straguz/hybrid-tube-amp/docs/bom+calcs.xlsx

Sheet: Calculations
Transistor V_BE: | 0.65 | small signal, nominal |  | Load resistance | 4 | Ohm |  | Transistor V_BE,min: | 0.2 V | For output devices at max temp
Supply voltage: | 32 | + and - |  | Worst case signal amplitude | 20.384 | V |  | Transitor V_BE, max | 1V | For output devices at min temp, worst tolerances
Input stage params: |  |  |  | VAS params |  |  |  | Output stage params
Standing Current | 0.01 | A |  | Standing current: | 0.01 | A |  | Pre-driver current: | 0.01 | A
Triode gates | 0 | V |  | R221: | 20 | Ohm |  | Driver current: | 0.015 | A
Triode cathodes | 0.7 | V | Vgk, from datasheet curves | R218: | 1000 | Ohm |  | Rballast | 0.1 | Ohm
R203, R206 | 50 | Ohm |  | R219: | 130 | Ohm |  | Vballast | 0.026 | V
R211 | 33000 | Ohm |  | RV201 | 1000 | Ohm |  | h_FE, output devices | 50
R212 | 133000 | Ohm |  | R222 | 18 | Ohm |  | h_FE, driver devices | 100
R208,209 | 10000 | Ohm |  | R216 | 10000 | Ohm |  | n output pairs | 2 | number of npn and pnp output device pairs
 |  |  |  | Q211,vce_cutoff: | 0.5 | V |  | reactive load derating: | 2 | effective current increase from reactive loads
 |  |  |  | Q213,vce_cutoff: | 0.5 | V
Input stage calcs: |  |  |  | VAS calcs: |  |  |  | Output calcs:
R211,R212 current: | 0.0001885542169 | A |  | R221 Vdrop | 0.2 | V |  | Quiescent current, output: | 0.26 | A
R211,R212 voltage divider: | 25.77771084 | V |  | Current limit | 0.0325 | A |  | Quiescent base current, output (per-device): | 0.0052 | A
C202,min: | 1.196653707 | uF | 1 Hz cutoff | R223: | 65 | Ohm |  | Output stage bias voltage: | 1.352 | V
Triode anodes: | 25.12771084 | V |  | Q210,Vc: | -30.7 | V |  | R229: | 90.13333333 | Ohm
Triode V_ak: | 24.42771084 | V | Design target 25V | Q210,Ic: | 0.00307 | A |  | Driver stage bias voltage: | 2.652 | V
R203,R206 Vdrop: | 0.25 | V |  | I,vbe_bias,min_bias: | 0.0005752212389 | A |  | R226: | 265.2 | Ohm
Q205 Vec: | 0.65 | V |  | I,vbe_bias,max_bias: | 0.005 | A |  | Bias generator voltage: | 3.952 | V
Q205 Vc (abs): | 31.1 | V |  | R222 Vdrop,min_bias | 0.1696460177 | V
Q201, Vc (abs): | 30.5 | V |  | R222 Vdrop,max_bias | 0.09 | V |  | Iout,peak: | 16 | A | Assumes rail to rail, and with 2x reactive load, so worst case
Q201, Vec: | 1.25 | V |  | Vbe_min_bias: | 1.055575221 | V | pot at max | Iout,rms,per device: | 4 | A | Divides evenly into all output pairs, and each conducts half the time
Q202,Vce: | 5.372289157 | V |  | Vbe_max_bias: | 5.56 | V | pot at 0 | Ib,rms,per device | 0.16 | A | Supplied by driver stage
Q206,Vce: | 5.972289157 | V |  | Q212,Ve: | -1.976 | V |  | Ib,driver,rms: | 0.0016 | A | Supplied by pre-drivers
R204: | 65 | Ohm |  | Q212,Vc: | 1.976 | V |  | Ib,pre-driver,rms: | 1.6e-05 | A | Supplied by VAS. negligible level for VAS calculations
Q207,Vc: | -30.7 | V |  | Q211,Vc,nom: | 2.105823009 | V | Rough mid-level R222 drop
Q207,Ic: | 0.001535 | A |  | Pos swing: | 29.19417699 | V |  | Pq,output,per | 8.32 | W
Q203,Vg: | -15.35 | V |  | Neg swing: | -28.874 | V |  | Pq,rballast,per | 0.00676 | W
Q204,Vc: | -16 | V |  | max rms: | 20.4170012 | V | before clipping | Q216,217 Pq: | 0.46986 | W
C201: | 31.83098862 | uF | minimum value for 1Hz cutoff | max load power: | 104.2134845 | W | At clipping | R229 Pq: | 0.02028 | W
 |  |  |  |  |  |  |  | Q214,215 Pq: | 0.0030674 | W
Input stage device power: | assumes all current in that device's branch |  |  | VAS device power: |  |  |  | R226 Pq: | 0.02652 | W
R203,R206: | 0.005 | W |  |  | 0.002 | W |  | Pq,total: | 34.2996948 | W | Total output stage power consumption, quiescent
Q201: | 0.0125 | W |  | Q211,quiescent | 0.2972453097 | W
Q205: | 0.0065 | W |  | R222 | 0.001598876185 | W |  | Poutput,signal,worst | 51.938432 | W | Assuming 40% load power
Q202: | 0.05372289157 | W |  | R218 | 0.025 | W |  | Poutput,per,worst | 34.289216 | W | Quiescent+signal power times reactivity factor
Q206: | 0.05972289157 | W |  | R219 | 0.00325 | W |  | Prballast,per,worst | 1.6 | W | Happens at full load power
Triodes: | 0.2442771084 | W |  | Q213,quiescent | 0.29374 | W |  | Poutput,total,worst: | 137.156864 | W | Signal output plus quiescent at worst-case load power
Q203: | 0.167 | W |  | R223 | 0.0065 | W |  | Pdriver,per,worst | 0.98924432 | W | Signal delivery requirements (output bases) plus quiescent at worst-case load
Q204: | 0.1535 | W |  | R216 | 0.094249 | W |  | Ppre-driver,per,worst | 0.0392712672 | W | Signal delivery requirements (driver bases) plus quiescent at worst-case load
R204: | 0.0065 | W |  | Q210 | 0.003991 | W
R208,209: | 0.02356225 | W |  |  |  |  |  | Poutput,total,worst-case | 139.8321796 | W | Not including power delivered to speakers
Q207: | 0.0019955 | W |  |  |  |  |  | Poutput,total,worst-case | 191.7706116 | W | Including power delivered to speakers
R211: | 0.001173238859 | W
R212 | 0.004728508129 | W
 |  |  |  | Total | 0.73824 | W | Ic*2x supplies, plus current mirror bias
Total: | 0.68912 | W | Ic*2x supplies, plus current mirror bias

Sheet: Other calculations
Gain:
R235 | 22000 | Ohm |  | max signal output,rms | 20.4170012
R234 | 1200 | Ohm
C205 | 1000 | uF
cutoff | 0.1326291192 | Hz
gain (V/V) | 19.33333333
gain (dB) | 25.72613478
sensitivity | 1.056051786 | V | max input voltage before clipping
