straguz/hybrid-tube-amp/hybrid-tube-amp.pdf

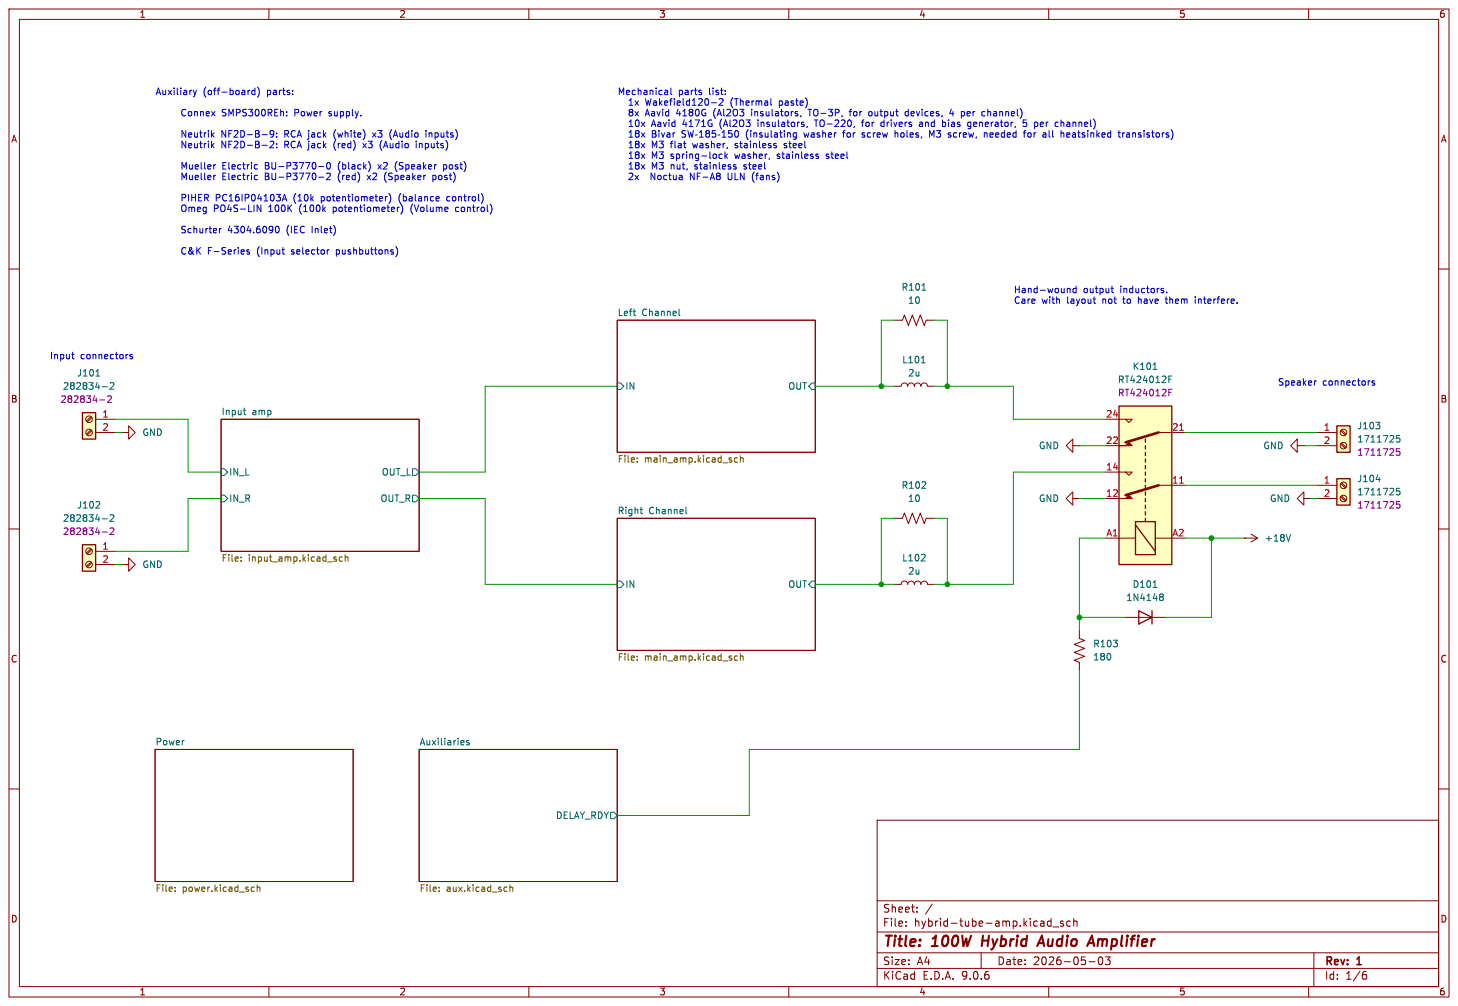
[picture p1: page 1]

Id: 1/6 Title: 100W Hybrid Audio Amplifier File: hybrid-tube-amp.kicad_sch Sheet: /

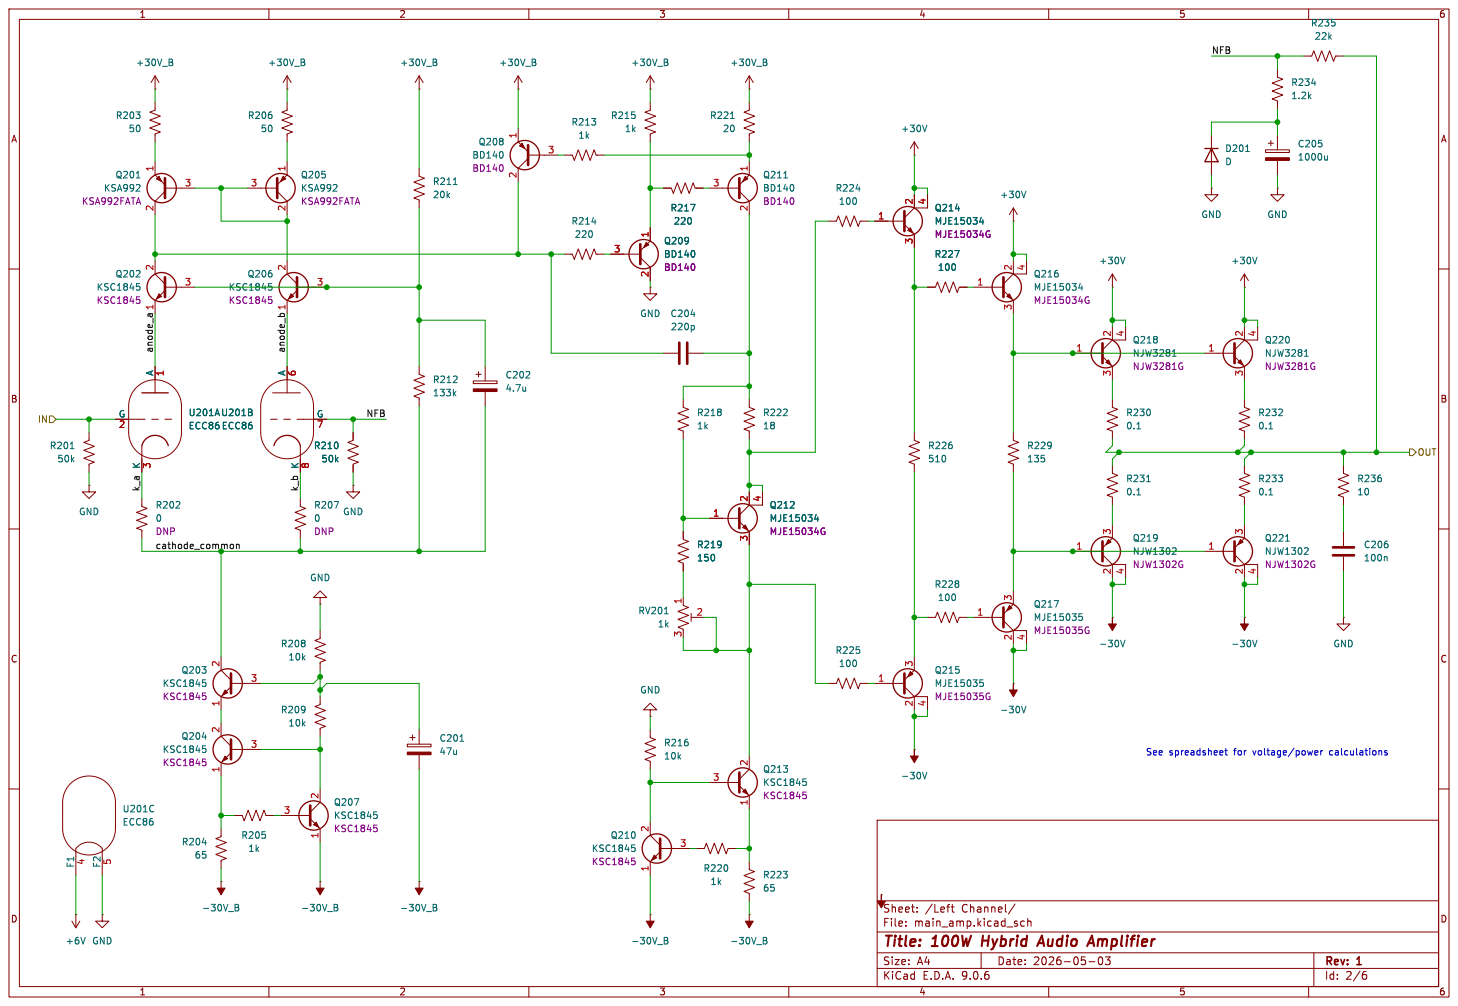
[picture p2: page 2]

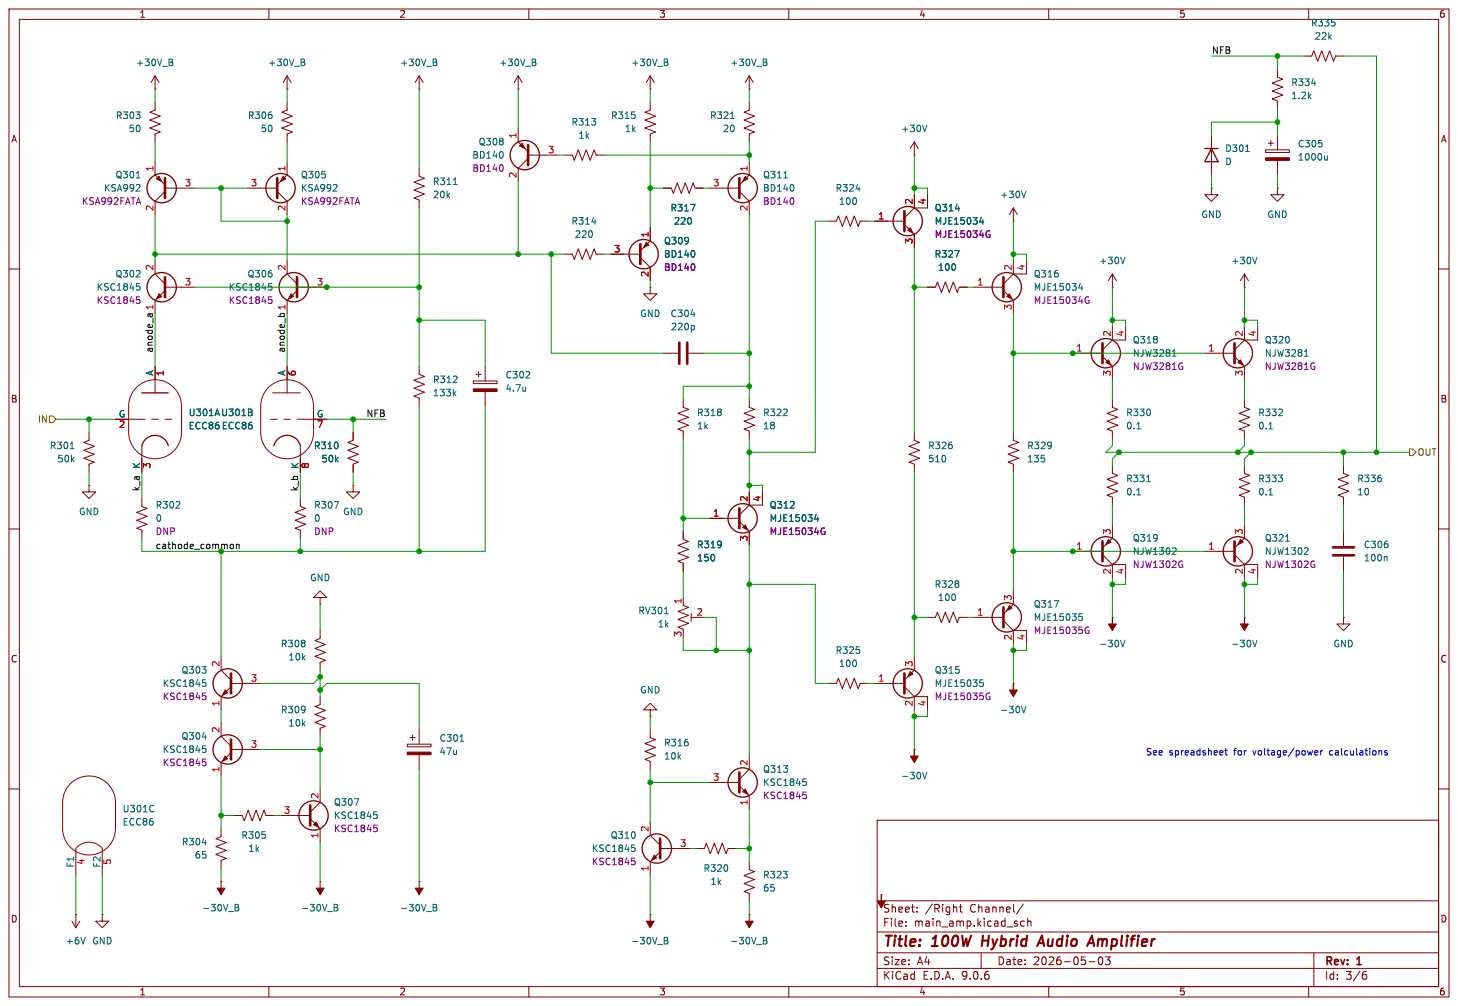
[picture p3: page 3]

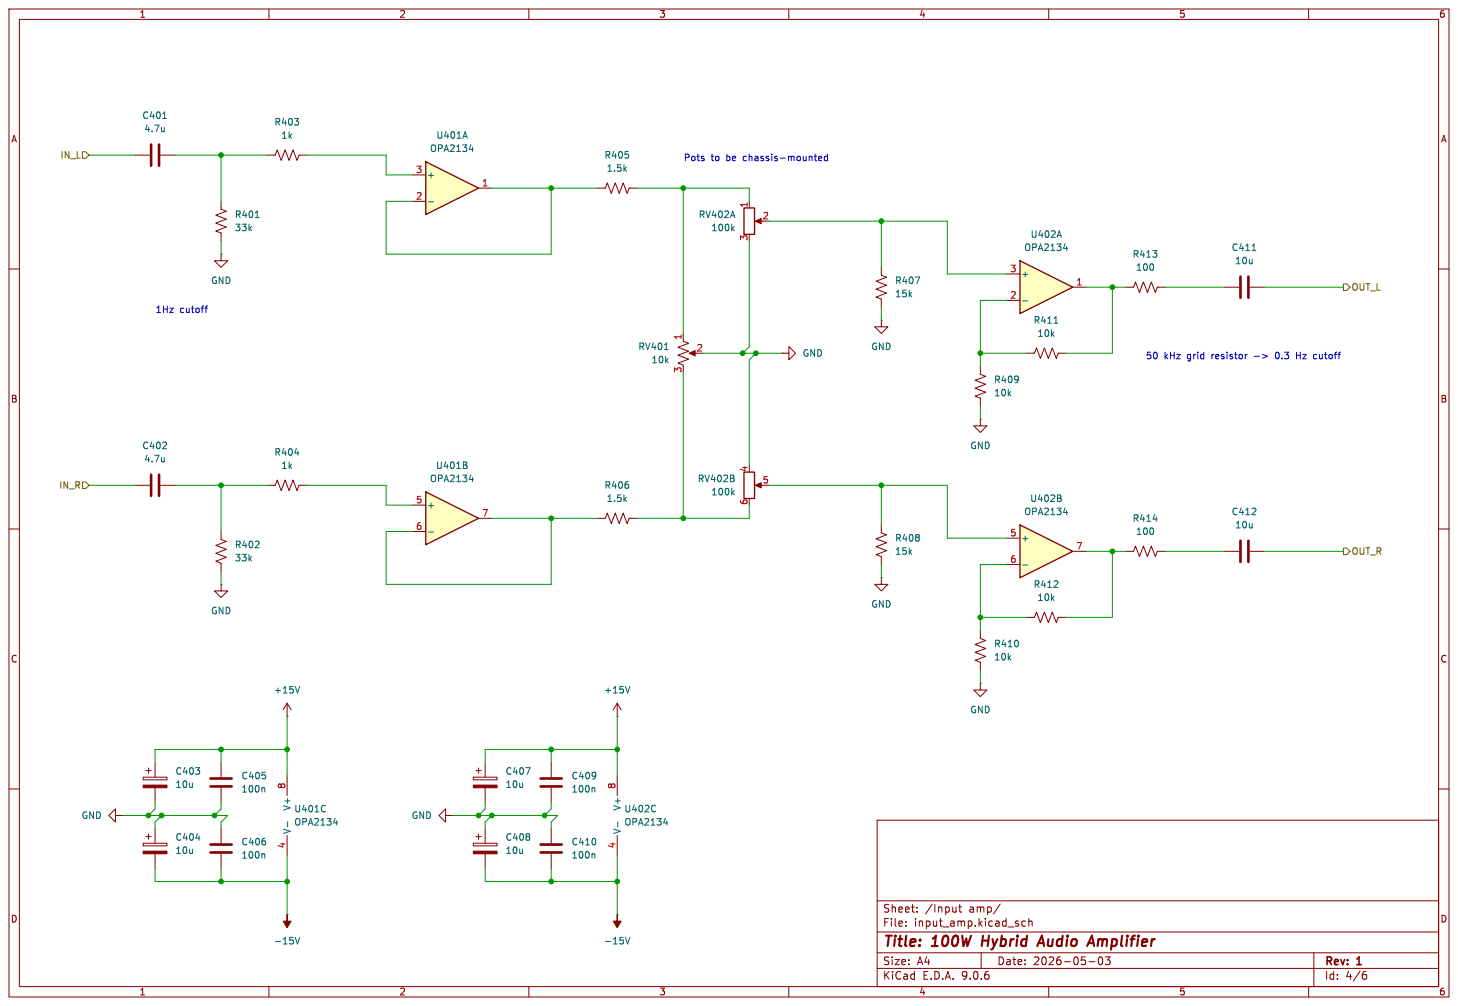
[picture p4: page 4]

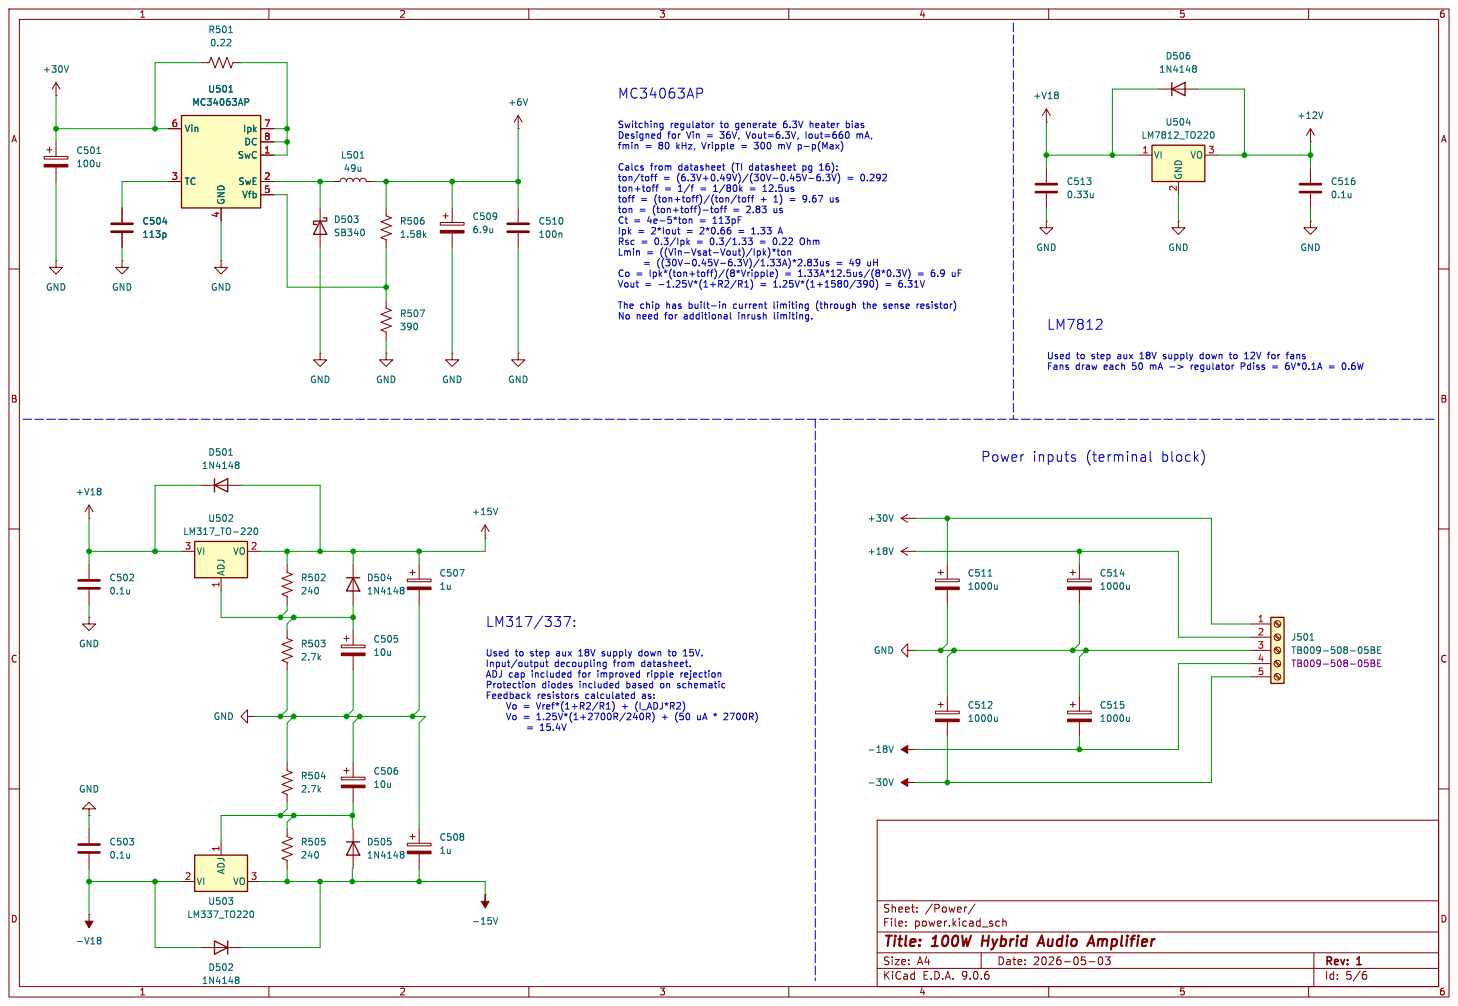
[picture p5: page 5]

Ipk 7 DC 8 SwC 1 SwE 2 Vfb 5 U501 MC34063AP

Ipk 7 DC 8 SwC 1 SwE 2 Vfb 5 C504

Id: 5/6 Title: 100W Hybrid Audio Amplifier File: power.kicad_sch Sheet: /Power/

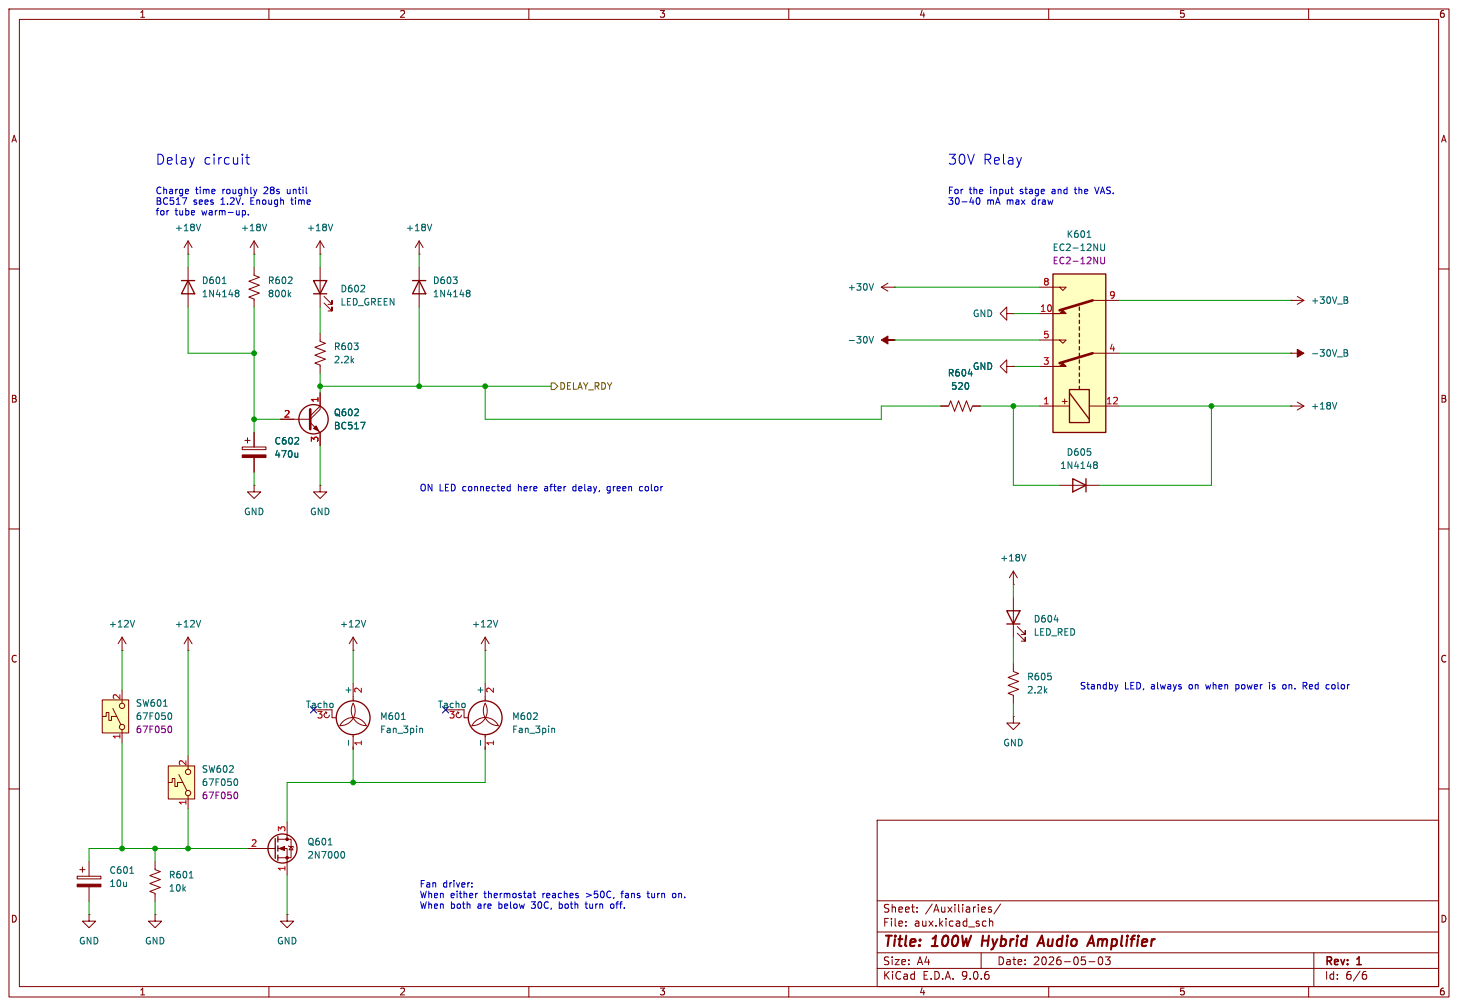
[picture p6: page 6]

Charge time roughly 28s until BC517 sees 1.2V. Enough time

for tube warm-up.

Id: 6/6 Title: 100W Hybrid Audio Amplifier File: aux.kicad_sch Sheet: /Auxiliaries/
