straguz/hybrid-tube-amp/aux.kicad_sch

## KiCad design aux.kicad_sch (2026-05-17, an earlier design)

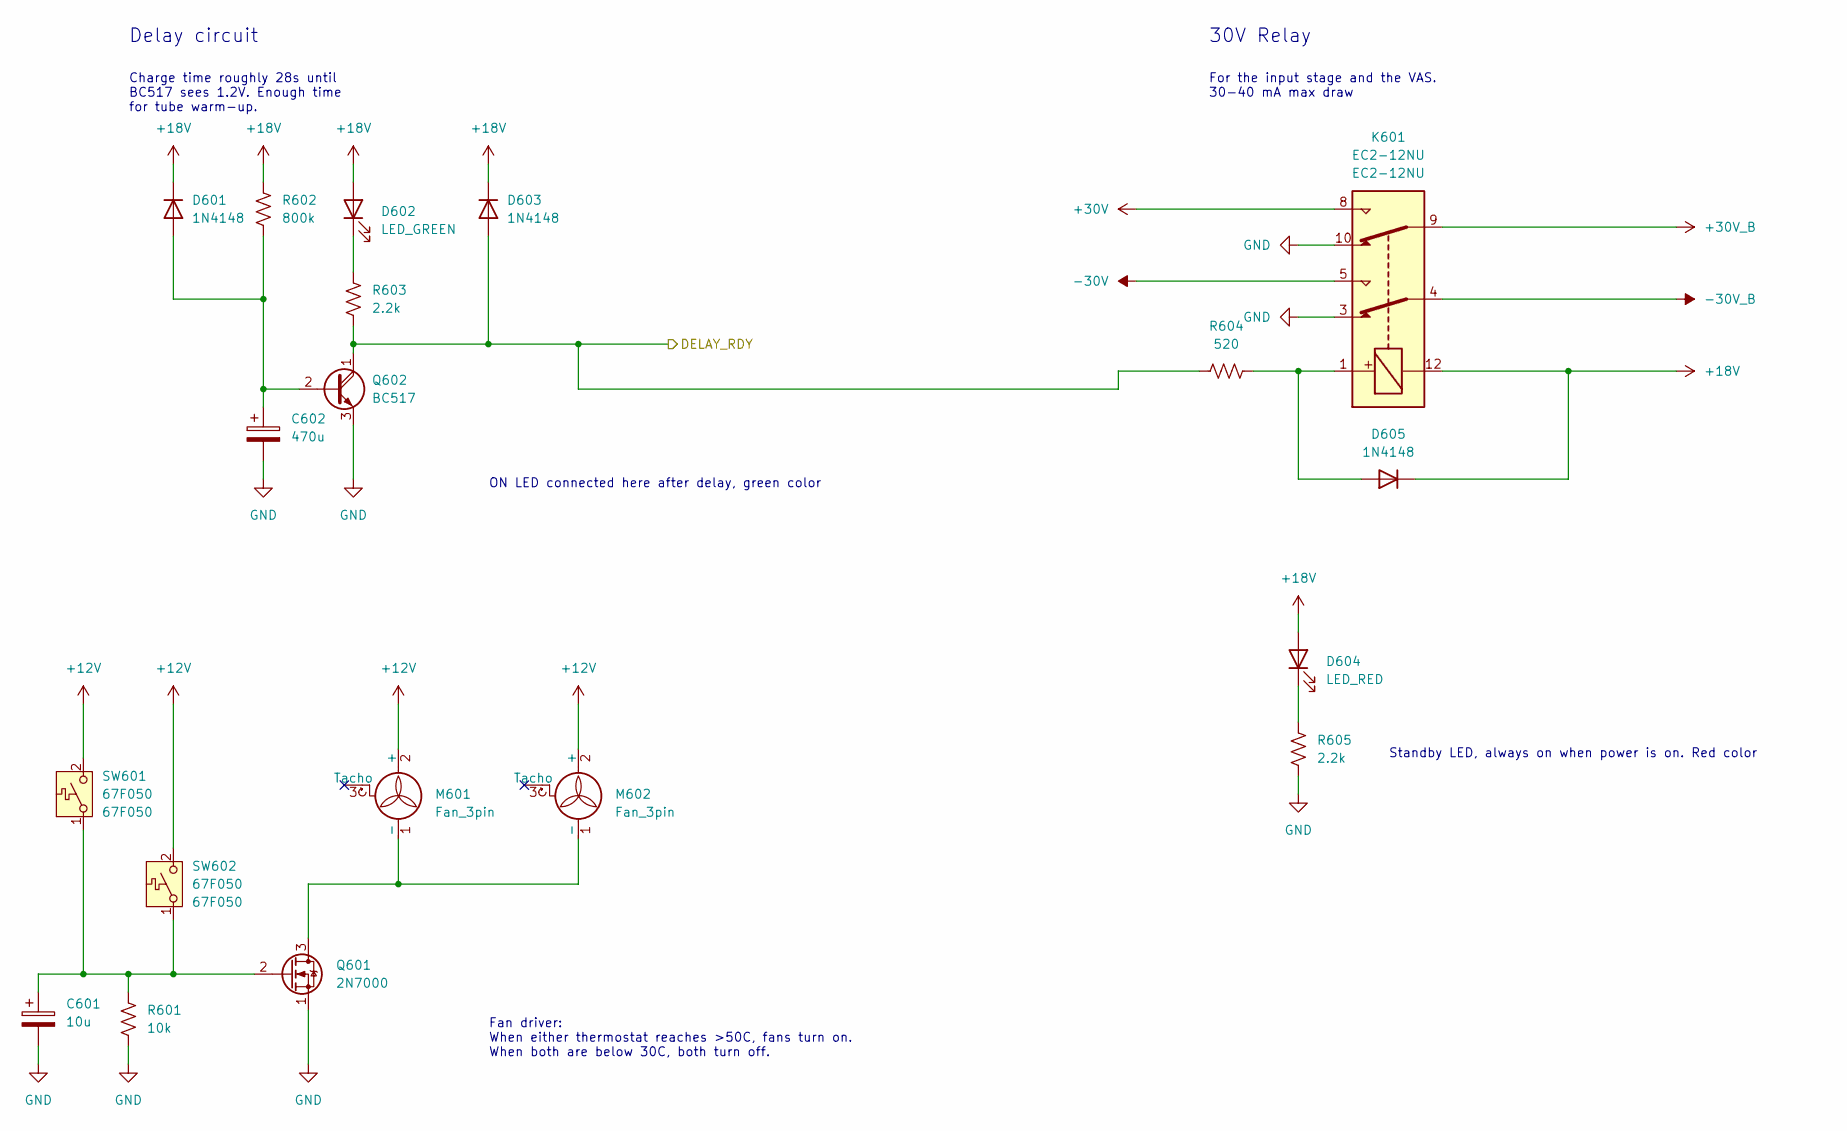
[picture p7: schematic aux.kicad_sch]

Parts:
C601: 10u
C602: 470u
D601, D603, D605: 1N4148
D602: LED_GREEN
D604: LED_RED
K601: EC2-12NU; Relay_DPDT_Kemet_EC2_NU; MPN EC2-12NU
M601, M602: Fan_3pin; FanPinHeader_1x03_P2.54mm_Vertical
Q601: 2N7000; TO-92_Inline
Q602: BC517; TO-92_Inline
R601: 10k
R602: 800k
R603, R605: 2.2k
R604: 520
SW601, SW602: 67F050; MPN 67F050

Connections:
+12V: M601.2 (+), M602.2 (+), SW601.2 (B), SW602.2 (B)
+18V: D601.1 (K), D602.2 (A), D603.1 (K), D604.2 (A), D605.1 (K), K601.12, R602.1
+30V: K601.8
+30V_B: K601.9
-30V: K601.5
-30V_B: K601.4
DELAY_RDY: D603.2 (A), Q602.1 (C), R603.2, R604.2
GND: C601.2, C602.2, K601.3, K601.10, Q601.1 (S), Q602.3 (E), R601.2, R605.2
unnamed: C601.1, Q601.2 (G), R601.1, SW601.1 (A), SW602.1 (A)
unnamed: C602.1, D601.2 (A), Q602.2 (B), R602.2
unnamed: D602.1 (K), R603.1
unnamed: D604.1 (K), R605.1
unnamed: D605.2 (A), K601.1, R604.1
unnamed: M601.1 (-), M602.1 (-), Q601.3 (D)

Notes on the sheet:
ON LED connected here after delay, green color
Charge time roughly 28s until BC517 sees 1.2V. Enough time for tube warm-up.
30V Relay
For the input stage and the VAS. 30-40 mA max draw
Standby LED, always on when power is on. Red color
Delay circuit
Fan driver: When either thermostat reaches >50C, fans turn on. When both are below 30C, both turn off.
