straguz/hybrid-tube-amp/input_amp.kicad_sch

## KiCad design input_amp.kicad_sch (2026-05-17, an earlier design)

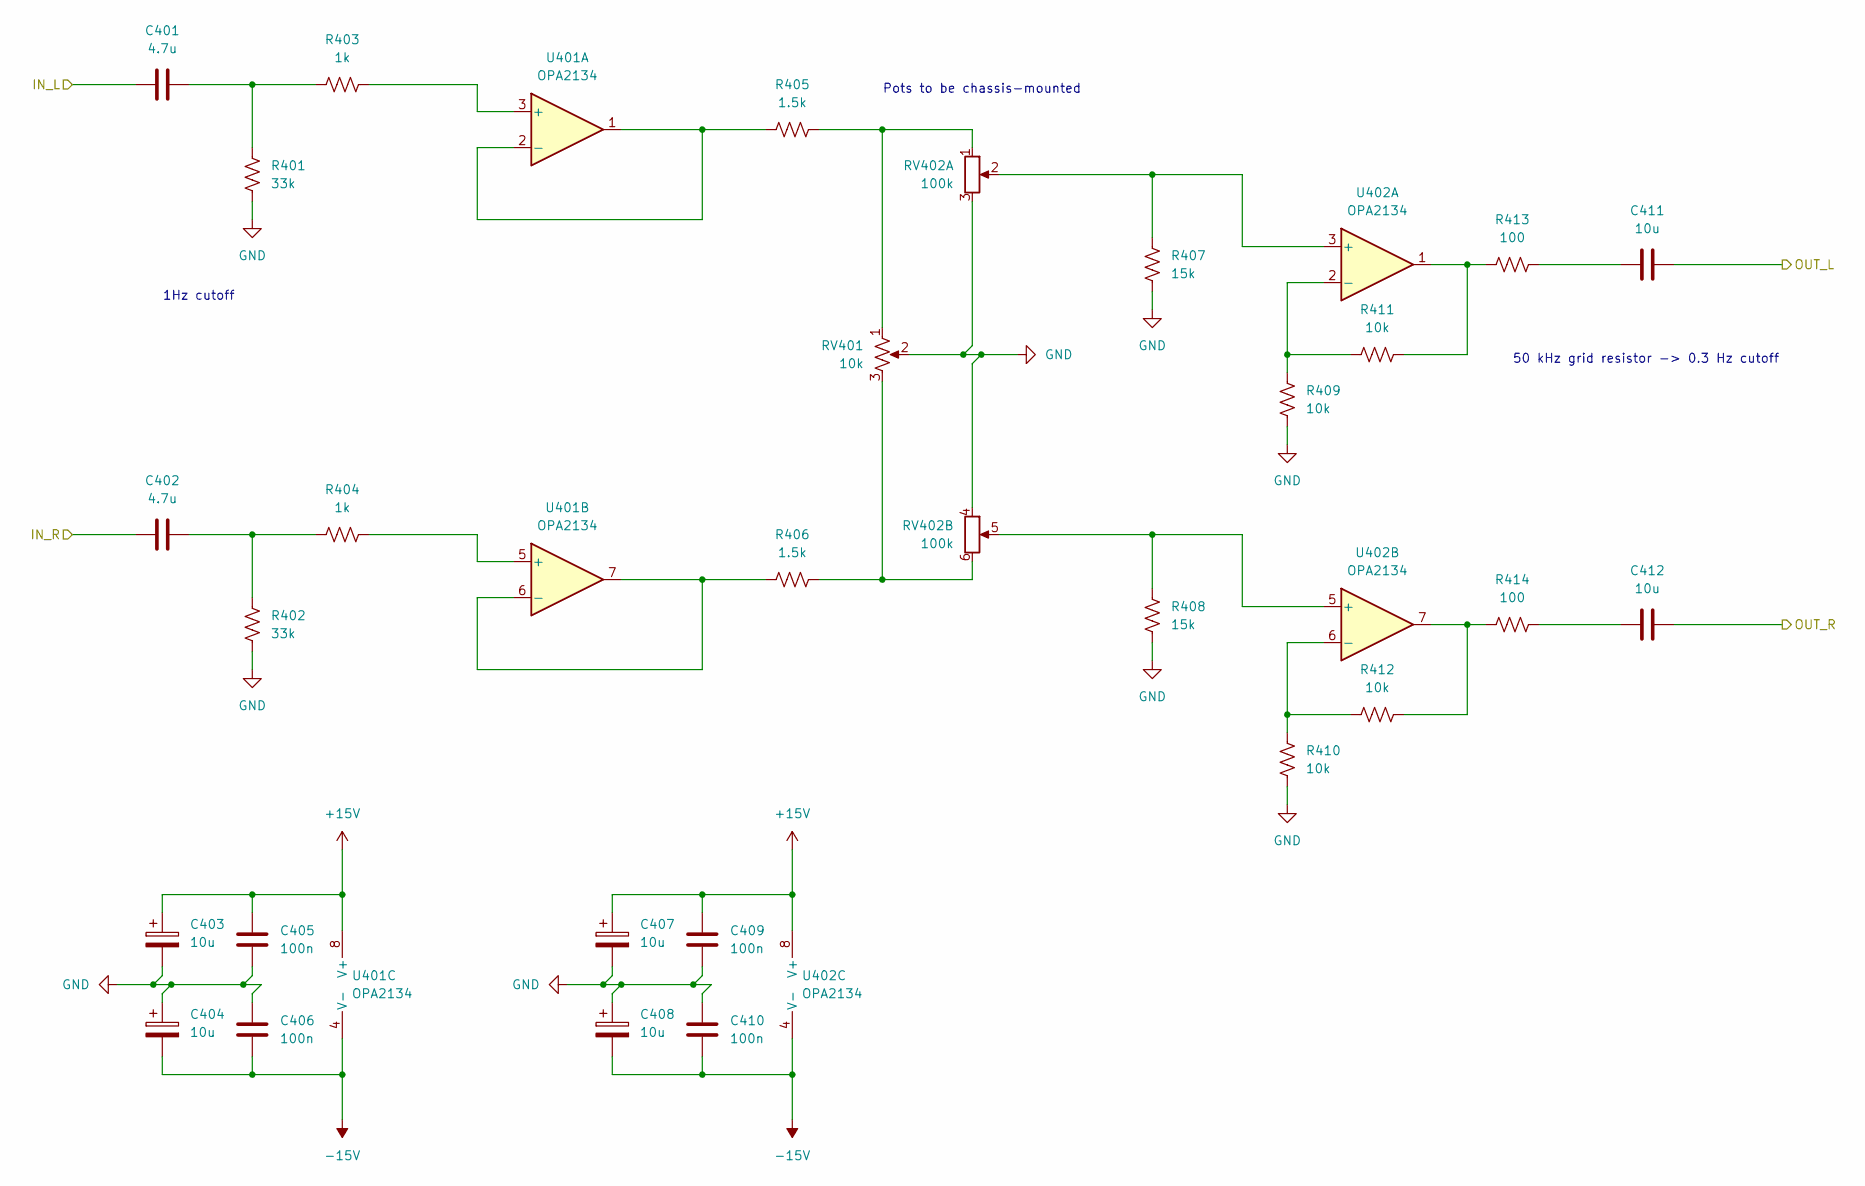
[picture p8: schematic input_amp.kicad_sch]

Parts:
C401, C402: 4.7u
C403, C404, C407, C408, C411, C412: 10u
C405, C406, C409, C410: 100n
R401, R402: 33k
R403, R404: 1k
R405, R406: 1.5k
R407, R408: 15k
R409, R410, R411, R412: 10k
R413, R414: 100
RV401: 10k
RV402: 100k
U401, U402: OPA2134

Connections:
+15V: C403.1, C405.2, C407.1, C409.2, U401.8 (V+), U402.8 (V+)
-15V: C404.2, C406.1, C408.2, C410.1, U401.4 (V-), U402.4 (V-)
GND: C403.2, C404.1, C405.1, C406.2, C407.2, C408.1, C409.1, C410.2, R401.2, R402.2, R407.2, R408.2, R409.2, R410.2, RV401.2, RV402.3, RV402.4
IN_L: C401.1
IN_R: C402.1
unnamed: C401.2, R401.1, R403.1
unnamed: C402.2, R402.1, R404.1
unnamed: C411.1, R413.1
unnamed: C412.1, R414.1
unnamed: R403.2, U401.3 (+)
unnamed: R404.2, U401.5 (+)
unnamed: R405.1, RV401.1, RV402.1
unnamed: R405.2, U401.1, U401.2 (-)
unnamed: R406.1, RV401.3, RV402.6
unnamed: R406.2, U401.6 (-), U401.7
unnamed: R407.1, RV402.2, U402.3 (+)
unnamed: R408.1, RV402.5, U402.5 (+)
unnamed: R409.1, R411.2, U402.2 (-)
unnamed: R410.1, R412.2, U402.6 (-)
unnamed: R411.1, R413.2, U402.1
unnamed: R412.1, R414.2, U402.7
OUT_L: C411.2
OUT_R: C412.2

Notes on the sheet:
50 kHz grid resistor -> 0.3 Hz cutoff
1Hz cutoff
Pots to be chassis-mounted
