straguz/hybrid-tube-amp/main_amp.kicad_sch

## KiCad design main_amp.kicad_sch (2026-05-17, an earlier design)

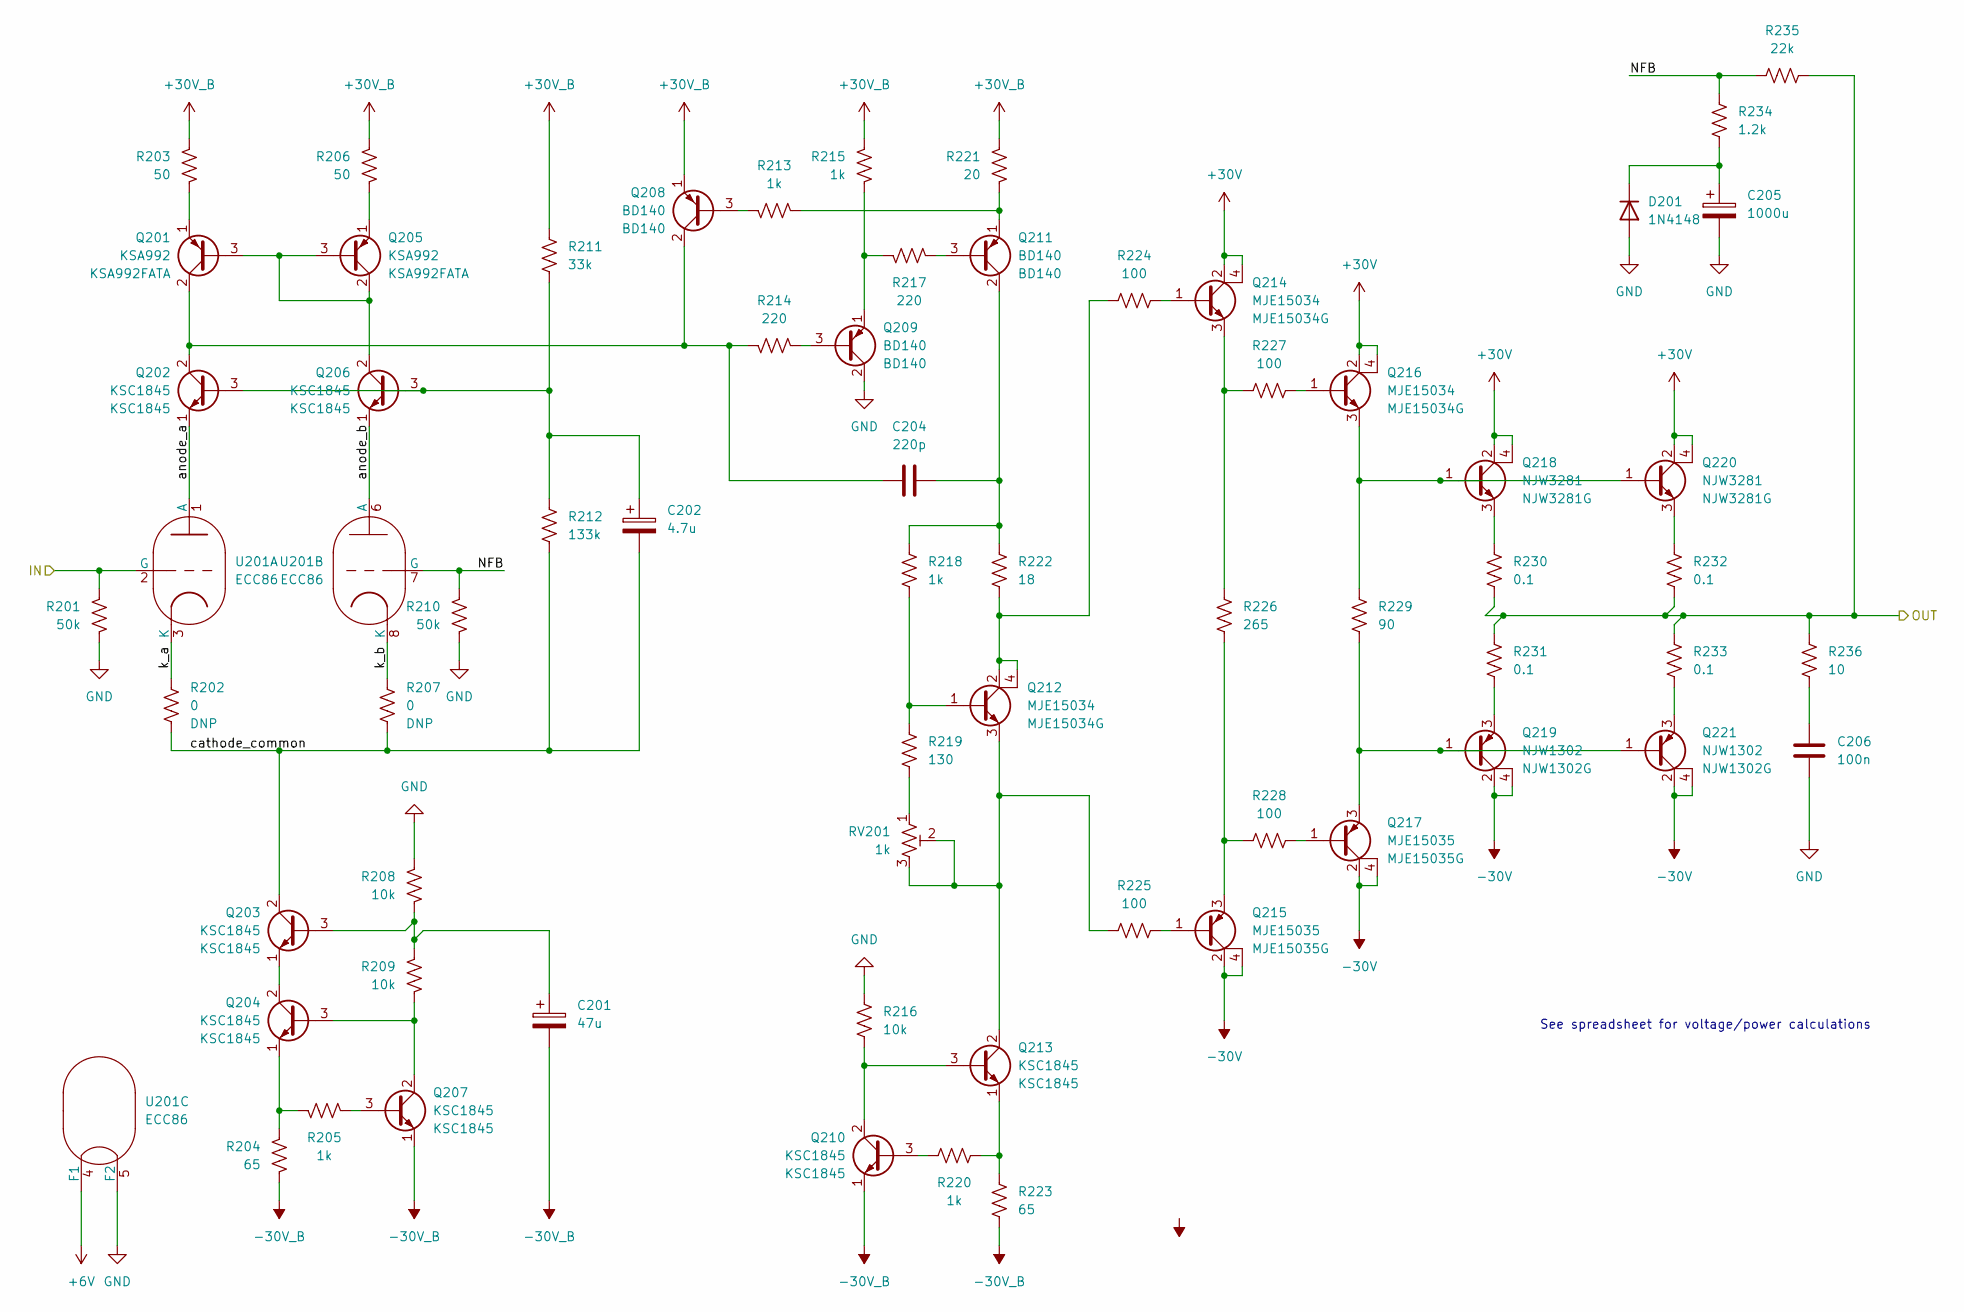
[picture p9: schematic main_amp.kicad_sch]

Parts:
C201: 47u
C202: 4.7u
C204: 220p
C205: 1000u
C206: 100n
D201: 1N4148
Q201, Q205: KSA992; MPN KSA992FATA
Q202, Q203, Q204, Q206, Q207, Q210, Q213: KSC1845; MPN KSC1845
Q208, Q209, Q211: BD140; TO-126-3_Vertical; MPN BD140
Q212, Q214, Q216: MJE15034; MPN MJE15034G
Q215, Q217: MJE15035; MPN MJE15035G
Q218, Q220: NJW3281; MPN NJW3281G
Q219, Q221: NJW1302; MPN NJW1302G
R201, R210: 50k
R202, R207: 0; MPN DNP
R203, R206: 50
R204, R223: 65
R205, R213, R215, R218, R220: 1k
R208, R209, R216: 10k
R211: 33k
R212: 133k
R214, R217: 220
R219: 130
R221: 20
R222: 18
R224, R225, R227, R228: 100
R226: 265
R229: 90
R230, R231, R232, R233: 0.1
R234: 1.2k
R235: 22k
R236: 10
RV201: 1k
U201: ECC86; Valve_Noval_P

Connections:
+6V: U201.4 (F1)
+30V: Q214.2 (C), Q214.4 (C), Q216.2 (C), Q216.4 (C), Q218.2 (C), Q218.4 (C), Q220.2 (C), Q220.4 (C)
+30V_B: Q208.1 (E), R203.1, R206.1, R211.1, R215.1, R221.1
-30V: Q215.2 (C), Q215.4 (C), Q217.2 (C), Q217.4 (C), Q219.2 (C), Q219.4 (C), Q221.2 (C), Q221.4 (C)
-30V_B: C201.2, Q207.1 (E), Q210.1 (E), R204.2, R223.2
GND: C205.2, C206.1, D201.2 (A), Q209.2 (C), R201.2, R208.1, R210.2, R216.1, U201.5 (F2)
IN: R201.1, U201.2 (G)
NFB: R210.1, R234.2, R235.1, U201.7 (G)
unnamed: C201.1, Q203.3 (B), R208.2, R209.1
unnamed: C202.1, Q202.3 (B), Q206.3 (B), R211.2, R212.1
unnamed: C204.1, Q201.2 (C), Q202.2 (C), Q208.2 (C), R214.1
unnamed: C204.2, Q211.2 (C), R218.1, R222.1
unnamed: C205.1, D201.1 (K), R234.1
unnamed: C206.2, R236.2
unnamed: Q201.1 (E), R203.2
unnamed: Q201.3 (B), Q205.2 (C), Q205.3 (B), Q206.2 (C)
unnamed: Q203.1 (E), Q204.2 (C)
unnamed: Q204.1 (E), R204.1, R205.1
unnamed: Q204.3 (B), Q207.2 (C), R209.2
unnamed: Q205.1 (E), R206.2
unnamed: Q207.3 (B), R205.2
unnamed: Q208.3 (B), R213.1
unnamed: Q209.1 (E), R215.2, R217.1
unnamed: Q209.3 (B), R214.2
unnamed: Q210.2 (C), Q213.3 (B), R216.2
unnamed: Q210.3 (B), R220.2
unnamed: Q211.1 (E), R213.2, R221.2
unnamed: Q211.3 (B), R217.2
unnamed: Q212.1 (B), R218.2, R219.1
unnamed: Q212.2 (C), Q212.4 (C), R222.2, R224.1
unnamed: Q212.3 (E), Q213.2 (C), R225.1, RV201.2, RV201.3
unnamed: Q213.1 (E), R220.1, R223.1
unnamed: Q214.1 (B), R224.2
unnamed: Q214.3 (E), R226.1, R227.1
unnamed: Q215.1 (B), R225.2
unnamed: Q215.3 (E), R226.2, R228.1
unnamed: Q216.1 (B), R227.2
unnamed: Q216.3 (E), Q218.1 (B), Q220.1 (B), R229.1
unnamed: Q217.1 (B), R228.2
unnamed: Q217.3 (E), Q219.1 (B), Q221.1 (B), R229.2
unnamed: Q218.3 (E), R230.1
unnamed: Q219.3 (E), R231.2
unnamed: Q220.3 (E), R232.1
unnamed: Q221.3 (E), R233.2
unnamed: R219.2, RV201.1
OUT: R230.2, R231.1, R232.2, R233.1, R235.2, R236.1
anode_a: Q202.1 (E), U201.1 (A)
anode_b: Q206.1 (E), U201.6 (A)
cathode_common: C202.2, Q203.2 (C), R202.2, R207.2, R212.2
k_a: R202.1, U201.3 (K)
k_b: R207.1, U201.8 (K)

Notes on the sheet:
See spreadsheet for voltage/power calculations
