straguz/hybrid-tube-amp/power.kicad_sch

## KiCad design power.kicad_sch (2026-05-17, an earlier design)

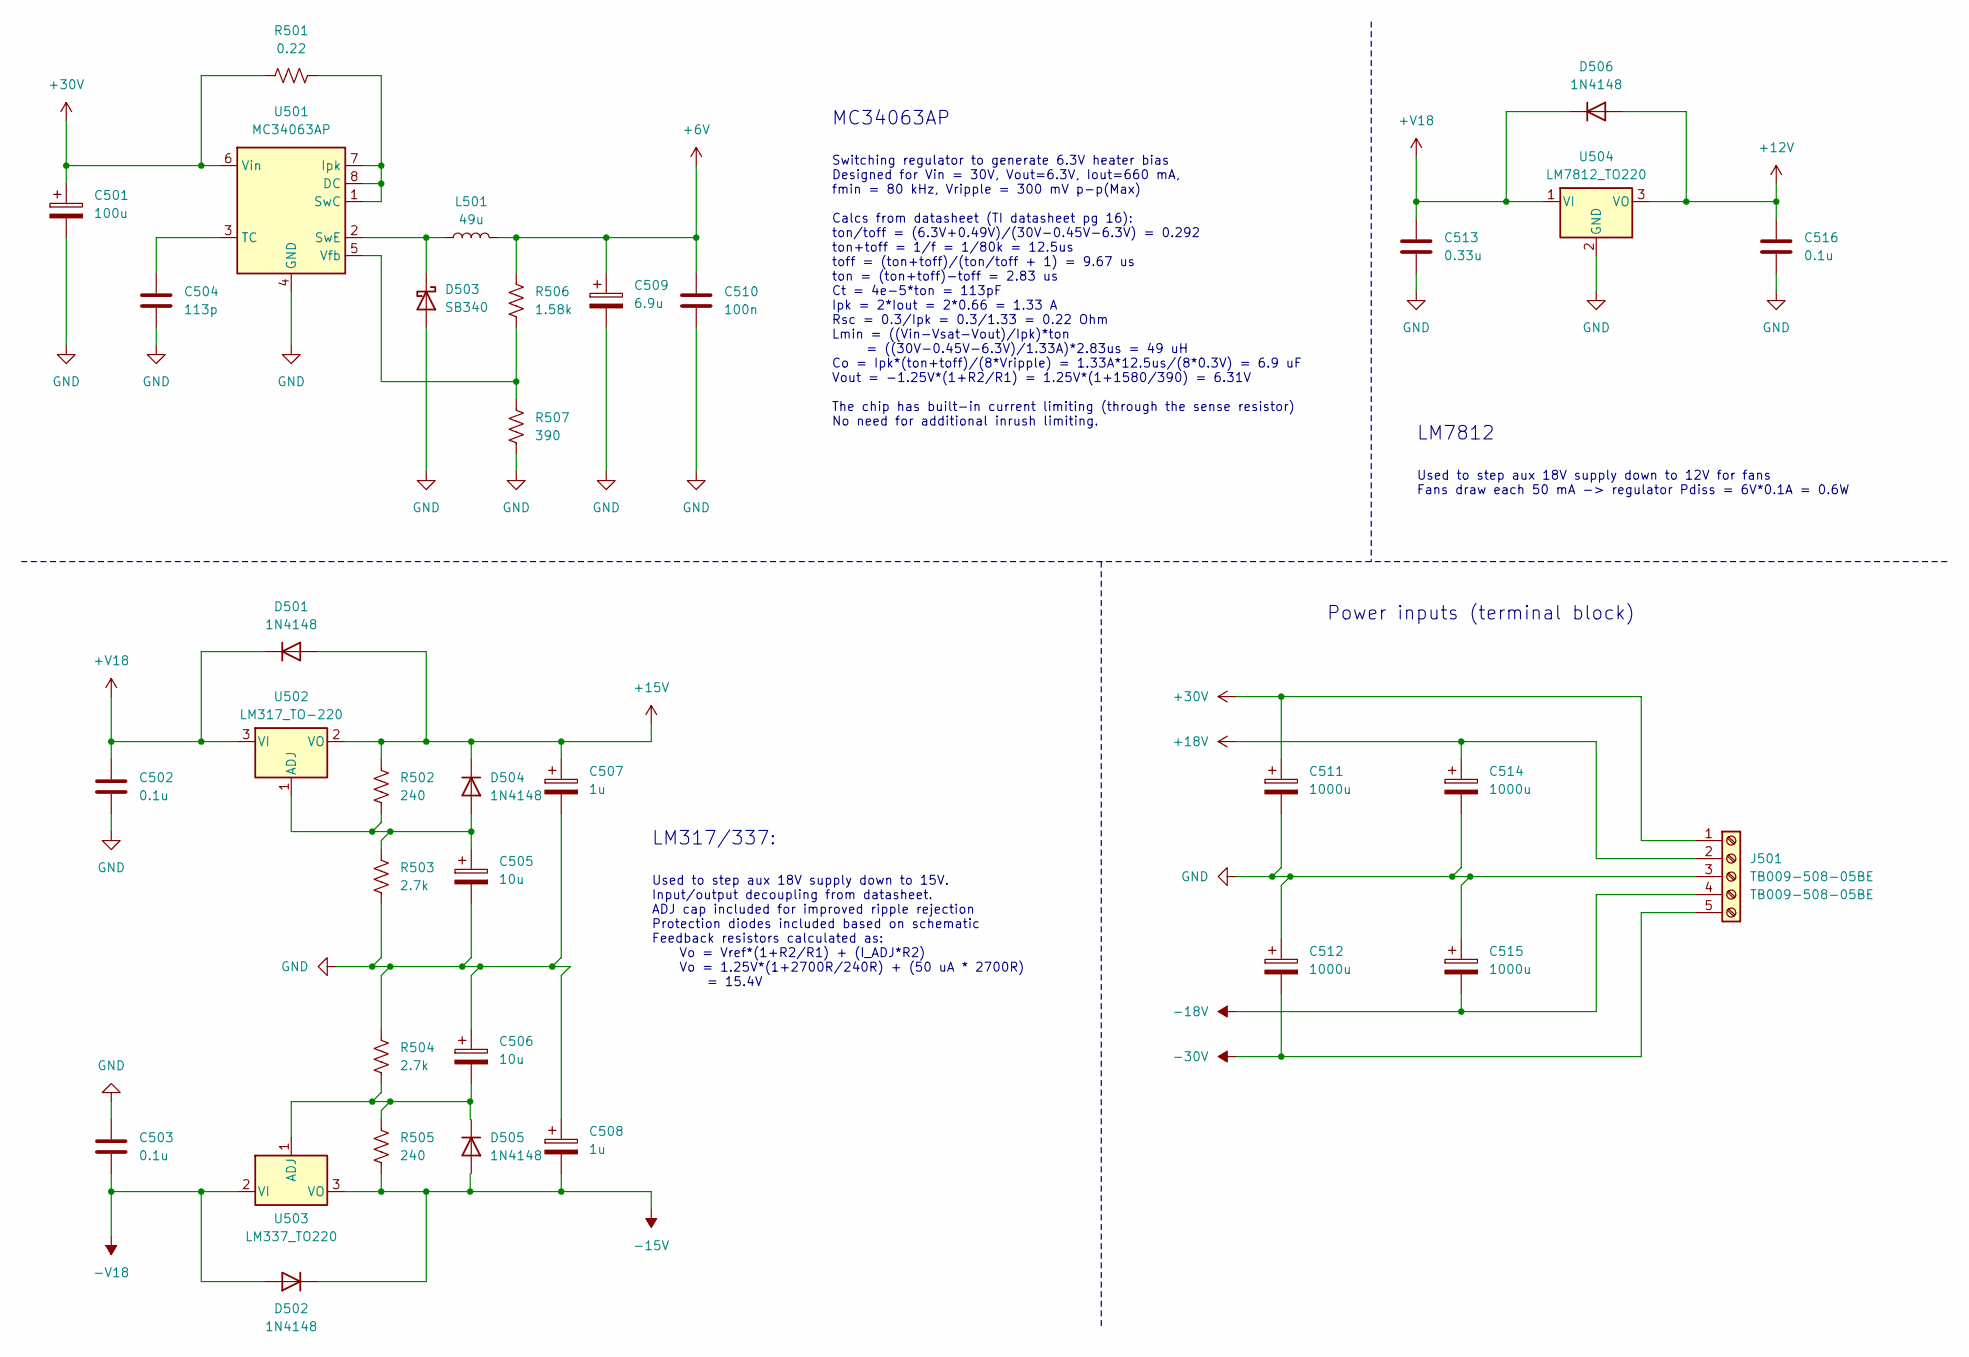
[picture p10: schematic power.kicad_sch]

Parts:
C501: 100u
C502, C503, C516: 0.1u
C504: 113p
C505, C506: 10u
C507, C508: 1u
C509: 6.9u
C510: 100n
C511, C512, C514, C515: 1000u
C513: 0.33u
D501, D502, D504, D505, D506: 1N4148
D503: SB340
J501: TB009-508-05BE; MPN TB009-508-05BE
L501: 49u
R501: 0.22
R502, R505: 240
R503, R504: 2.7k
R506: 1.58k
R507: 390
U501: MC34063AP; DIP-8_W7.62mm
U502: LM317_TO-220; TO-220-3_Vertical
U503: LM337_TO220; TO-220-3_Vertical
U504: LM7812_TO220; TO-220-3_Vertical

Connections:
+6V: C509.1, C510.1, L501.2, R506.2
+12V: C516.1, D506.2 (A), U504.3 (VO)
+15V: C507.1, D501.2 (A), D504.1 (K), R502.2, U502.2 (VO)
+18V: C514.1, J501.2
+30V: C501.1, C511.1, J501.1, R501.2, U501.6 (Vin)
+V18: C502.1, C513.1, D501.1 (K), D506.1 (K), U502.3 (VI), U504.1 (VI)
-15V: C508.2, D502.1 (K), R505.1, U503.3 (VO)
-18V: C515.2, J501.4
-30V: C512.2, J501.5
-V18: C503.2, D502.2 (A), U503.2 (VI)
GND: C501.2, C502.2, C503.1, C504.2, C505.2, C506.1, C507.2, C508.1, C509.2, C510.2, C511.2, C512.1, C513.2, C514.2, C515.1, C516.2, D503.2 (A), J501.3, R503.2, R504.1, R507.2, U501.4 (GND), U504.2 (GND)
unnamed: C504.1, U501.3 (TC)
unnamed: C505.1, D504.2 (A), R502.1, R503.1, U502.1 (ADJ)
unnamed: C506.2, R504.2, R505.2, U503.1 (ADJ)
unnamed: D503.1 (K), L501.1, U501.2 (SwE)
unnamed: R501.1, U501.1 (SwC), U501.7 (Ipk), U501.8 (DC)
unnamed: R506.1, R507.1, U501.5 (Vfb)

Notes on the sheet:
LM317/337:
Switching regulator to generate 6.3V heater bias Designed for Vin = 30V, Vout=6.3V, Iout=660 mA, fmin = 80 kHz, Vripple = 300 mV p-p(Max) Calcs from datasheet (TI datasheet pg 16): ton/toff = (6.3V+0.49V)/(30V-0.45V-6.3V) = 0.292 ton+toff = 1/f = 1/80k = 12.5us toff = (ton+toff)/(ton/toff + 1) = 9.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
Used to step aux 18V supply down to 12V for fans Fans draw each 50 mA -> regulator Pdiss = 6V*0.1A = 0.6W
MC34063AP
LM7812
Power inputs (terminal block)
Used to step aux 18V supply down to 15V. Input/output decoupling from datasheet. ADJ cap included for improved ripple rejection Protection diodes included based on schematic Feedback resistors calculated as: Vo = Vref*(1+R2/R1) + (I_ADJ*R2) Vo = 1.25V*(1+2700R/240R) + (50 uA * 2700R) = 15.4V
