straguz/hybrid-tube-amp/(commit log)

2026-03-28 First commit, blank project
    [hybrid-tube-amp.kicad_pcb, hybrid-tube-amp.kicad_sch]
2026-05-03 Updated schematic up to but not including BOM and footprint assignment
    [amp-calcs.kicad_sch, aux.kicad_sch, bom+calcs.xlsx, hybrid-tube-amp.kicad_sch, input_amp.kicad_sch, main_amp.kicad_sch, ordered-parts.csv, power.kicad_sch]
2026-05-03 removed obsolete page from repo
    [amp-calcs.kicad_sch]
2026-05-17 Completed schematic
    [aux.kicad_sch, hybrid-tube-amp.csv, hybrid-tube-amp.kicad_sch, input_amp.kicad_sch, main_amp.kicad_sch, power.kicad_sch]
2026-05-17 updated to Kicad 10
    [aux.kicad_sch, hybrid-tube-amp.kicad_sch, input_amp.kicad_sch, main_amp.kicad_sch, power.kicad_sch]
